dduyh/multi-channel-fluorescence-microscopy/README.md

# multi-channel-fluorescence-microscopy
Codes for a self-built  Multi-channel Fluorescence Microscopy with designed Low-cost Iillumination Module.
